GGm4nS3c/ufomount/README.md

# ufomount

Montura PTZ (pan-tilt) para cámara, controlada por Arduino UNO con shield
Ethernet y dos servos brushless GXservo GX3350ProBLS "X50 Pro":

- **Eje X (pan): 270°** — señal en D2
- **Eje Y (tilt): 180°** — señal en D3

Interfaz de escritorio en Python para el control fino (zoom) y el
seguimiento rápido (aviones), con posición en vivo, velocidades
configurables y log de actividad. Se conecta por USB o por red.

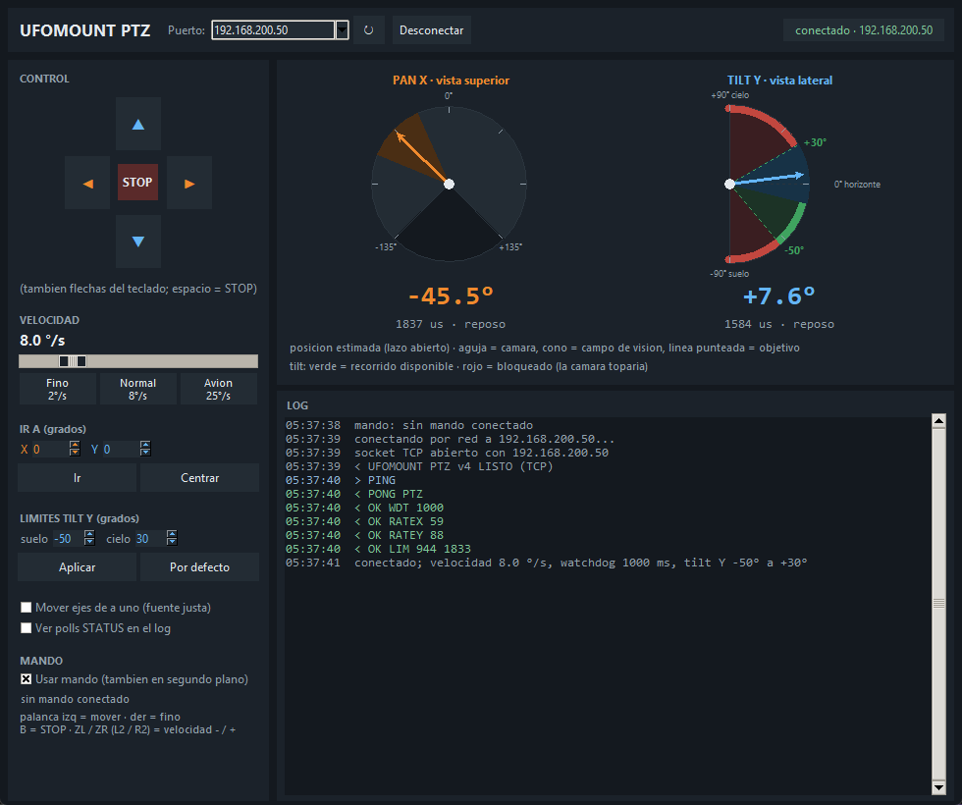
[picture p1: docs/img/gui-ptz.png]
GUI de control conectada a la montura por red: dial de pan, dial de tilt con el recorrido permitido en verde y el bloqueado en rojo, y log


## Estructura

| Ruta | Qué es |
|---|---|
| `firmware/ptztest/` | Firmware del UNO (v4): protocolo de líneas por USB y TCP, rampas de velocidad, auto-detach antizumbido, watchdog de enlace |
| `scripts/ptz_gui.py` | Interfaz gráfica (tkinter + pyserial): jog, presets de velocidad, diales de posición, logs |
| `scripts/*.ps1` | Utilidades por USB: verificación guiada, jog por consola, medición de consumo |
| `docs/GX3350-informe.md` | Informe técnico de los servos (specs, PWM, alimentación) |

## Uso rápido

```powershell
# Firmware (una vez): librerías y carga con arduino-cli
arduino-cli lib install Servo Ethernet
arduino-cli compile --fqbn arduino:avr:uno firmware/ptztest
arduino-cli upload -p COM5 --fqbn arduino:avr:uno firmware/ptztest

# Interfaz
pip install pyserial
pip install pygame                               # opcional: control por mando
python scripts/ptz_gui.py                        # último puerto que conectó (o la red)
python scripts/ptz_gui.py --port COM5            # USB
python scripts/ptz_gui.py --port 192.168.200.50  # red
```

En la GUI, el desplegable de puerto ofrece los COM detectados, la IP de
respaldo `192.168.200.50:5000` y las monturas que encuentre *Buscar*;
también se puede escribir otra `IP:puerto`. La GUI
recuerda el último puerto que conectó (en `~/.ufomount_ptz.json`, junto con
los límites del tilt).

## Control por mando

Con `pygame` instalado, la GUI lee un mando (probado con el Nintendo Switch
Pro Controller por USB; también sirven Xbox, PlayStation y genéricos) y
**sigue funcionando con la ventana en segundo plano**.

| Mando | Acción |
|---|---|
| Palanca izquierda | Mueve pan/tilt; cuanto más se inclina, más rápido (hasta la velocidad elegida en la GUI) |
| Palanca derecha | Igual, pero a un 25 % de esa velocidad (ajuste fino) |
| B | STOP |
| ZL / ZR (L2 / R2) | Preset de velocidad anterior / siguiente (Fino, Normal, Avión) |

Al soltar la palanca el eje se detiene. Respeta los límites del tilt; en
diagonal mueve los dos ejes a la vez, salvo que se marque "Mover ejes de a
uno" (entonces solo el más inclinado; útil con una fuente justa). La casilla *Usar
mando* lo desactiva; debajo se ven las palancas en vivo.

## Límites del tilt (eje Y)

Para que la cámara no tope, el eje Y solo recorre de **-50°** (suelo) a
**+30°** (cielo), con 0° = horizonte (1500 µs).

- El firmware arranca con ese rango (`LIMY 944 1833`), así queda protegido
  aunque no haya GUI conectada.
- En la GUI, *Límites tilt Y* permite cambiarlo; se guarda en
  `~/.ufomount_ptz.json` y se envía al firmware en cada conexión. *Por
  defecto* vuelve a -50°/+30°.
- El dial del tilt muestra en verde el recorrido disponible y en rojo el
  bloqueado.

## Control por red

| Parámetro | Valor (en `ptztest.ino`) |
|---|---|
| IP | Por **DHCP** al encender; si no hay servidor DHCP en 8 s, IP fija de respaldo 192.168.200.50 / 24 (gateway .254) |
| Puerto TCP | 5000 |
| Descubrimiento | UDP 5000: a `UFOMOUNT?` contesta `UFOMOUNT PTZ v4.1 ip=<ip>:5000 ...` |
| MAC | 02:55:46:4F:00:01 (administrada localmente) |

- **Encontrar la montura**: botón *Buscar* de la GUI (o
  `python scripts/ptz_gui.py --find`). Busca en la red local y, si en
  *Puerto* hay una IP de otra red (por ejemplo `192.168.210.0`), recorre
  también esa red /24: el broadcast no cruza routers.
- Para que tenga siempre la misma IP, reservarla en el router (DHCP) para
  la MAC de arriba. La red se toma al encender: al cambiarla de red,
  reiniciar la placa.
- Mismo protocolo que por USB (`PING`, `X <us>`, `STATUS`…), una línea por
  comando. `NET` informa el chip de la shield, el enlace, la IP (dhcp o
  fija) y el cliente.
- USB y red funcionan a la vez. Una conexión TCP a la vez: una nueva
  reemplaza a la anterior.
- Si la conexión TCP que movía la montura se cae, o su canal deja de
  hablar con el watchdog activo, la montura se detiene.
- Por red el UNO **no** se resetea al conectar (por USB sí): conserva su
  posición.
- Prueba manual: PuTTY en modo *Raw* a la IP de la montura, puerto 5000.
- Sin autenticación: pensado para una LAN de confianza.

## Conexionado

| Cable del servo | Va a |
|---|---|
| Franja blanca (señal) | D2 (X) / D3 (Y) |
| Central (V+) | Fuente externa 6,0–8,4 V (nunca el 5V del Arduino) |
| Restante (GND) | Negativo de fuente + GND del Arduino (tierra común) |

La shield Ethernet ocupa D10 (chip-select), D11–D13 (SPI) y D4 (SD): no
conectar servos ahí. Si la shield tiene soldado el puente de interrupción
(INT) a D2, ese pin también queda ocupado.

Si el RJ45 de la shield se apoya en el USB del UNO, la shield no calza a
fondo y los pines de ese extremo (D8–D10) pueden quedar sin contacto: usar
extensores de pines o cinta aislante sobre el USB.

Fuente recomendada para ambos ejes: ≥10 A a 6 V o ≥12 A a 7,4 V.
Detalles, protocolo serie completo y fuentes en
[docs/GX3350-informe.md](docs/GX3350-informe.md).

## Paquete portable

`python -m PyInstaller --onefile --windowed --name UfomountPTZ scripts/ptz_gui.py`
genera el ejecutable standalone (los binarios no se versionan; ver
Releases si hay alguno publicado). Con `pygame` instalado al compilar, el
`.exe` incluye el soporte de mando: en otro equipo con Windows 10/11 de 64
bits no hace falta instalar Python ni drivers. Al ser un ejecutable sin
firma, SmartScreen puede avisar la primera vez (*Más información →
Ejecutar de todas formas*).
