GGm4nS3c/ufomount/scripts/ptz_gui.py

#!/usr/bin/env python3
"""Interfaz de control de la montura PTZ ufomount.

Habla con el firmware ptztest v4 (Arduino UNO + shield Ethernet), por USB
(115200 baudios) o por red (TCP, mismo protocolo de lineas).
Eje X = pan 270 grados (D2) - Eje Y = tilt 180 grados (D3).

Uso:
    python scripts/ptz_gui.py                       # ultimo puerto que conecto (o red)
    python scripts/ptz_gui.py --port COM7           # por USB
    python scripts/ptz_gui.py --port 192.168.200.50 # por red (puerto 5000)
    python scripts/ptz_gui.py --check               # prueba de conexion sin GUI (COM5)
    python scripts/ptz_gui.py --find 192.168.210.0  # busca monturas (aqui y en esa red)

La posicion mostrada es la ESTIMADA (lazo abierto): el firmware sabe
donde comando al servo; el servo no tiene salida de telemetria real.
"""

import argparse
import json
import math
import os
import queue
import re
import socket
import sys
import threading
import time
import tkinter as tk
from pathlib import Path
from tkinter import ttk

try:
    import serial
    import serial.urlhandler.protocol_socket  # noqa: F401  (socket://, PyInstaller)
    from serial.tools import list_ports
except ImportError:
    print("Falta pyserial:  python -m pip install pyserial")
    sys.exit(1)

try:   # mando opcional: python -m pip install pygame
    os.environ.setdefault("SDL_JOYSTICK_ALLOW_BACKGROUND_EVENTS", "1")  # sin foco
    os.environ.setdefault("SDL_WINDOWS_ENABLE_MESSAGELOOP", "0")  # no tocar a Tk
    os.environ.setdefault("PYGAME_HIDE_SUPPORT_PROMPT", "1")
    import pygame
    from pygame._sdl2 import controller as sdl_controller
except ImportError:
    pygame = None

# ----------------------------- configuracion -----------------------------
PORT_DEFAULT = "COM5"
BAUD = 115200
BOOT_WAIT_S = 2.5          # el UNO se resetea al abrir el puerto
NET_DEFAULT = "192.168.200.50:5000"   # IP de respaldo del firmware (sin DHCP)
NET_TCP_PORT = 5000
NET_WAIT_S = 0.3           # por red no hay reset: solo esperar el saludo
DISCOVERY_PORT = 5000      # UDP: "UFOMOUNT?" -> la montura contesta su IP
DISCOVERY_MSG = b"UFOMOUNT?"
DISCOVERY_WAIT_S = 1.5
IP_RE = re.compile(r"\b\d{1,3}(?:\.\d{1,3}){3}\b")

X_MIN, X_MAX = 500, 2500   # pulso (us)
Y_MIN, Y_MAX = 500, 2500
X_DEG_TOTAL = 270.0        # recorrido fisico del eje X
Y_DEG_TOTAL = 180.0
INVERT_X = True            # el servo X gira al reves (subir el pulso = izquierda)
INVERT_Y = False
Y_LIM_DEFAULT = (-50.0, 30.0)   # tilt permitido (suelo, cielo): mas alla topa
CONFIG_PATH = Path.home() / ".ufomount_ptz.json"   # limites elegidos en la GUI

X_US_PER_DEG = (X_MAX - X_MIN) / X_DEG_TOTAL   # ~7.41
Y_US_PER_DEG = (Y_MAX - Y_MIN) / Y_DEG_TOTAL   # ~11.11

SPEED_PRESETS = [("Fino", 2.0), ("Normal", 8.0), ("Avion", 25.0)]  # grados/s
SPEED_MIN, SPEED_MAX = 0.5, 40.0

PAD_POLL_MS = 50
PAD_DEADZONE = 0.15        # las palancas del Switch Pro derivan un poco
PAD_FINE = 0.25            # palanca derecha: fraccion de la velocidad elegida
PAD_TRIGGER_ON, PAD_TRIGGER_OFF = 0.6, 0.3   # ZL/ZR (L2/R2) como botones

STATUS_POLL_S = 0.2
CMD_SETTLE_S = 0.7         # ventana en que un comando aun no se refleja en STATUS
WDT_MS = 1000              # watchdog de enlace en el firmware

STATUS_RE = re.compile(
    r"attX=(\d) attY=(\d) X=(\d+)/(\d+) \[(\d+)-(\d+)\]"
    r" Y=(\d+)/(\d+) \[(\d+)-(\d+)\] rateX=(\d+) rateY=(\d+) idle=(\d+)"
)
NET_RE = re.compile(r"^\d{1,3}(?:\.\d{1,3}){3}(?::\d+)?$")

# ------------------------------- colores ---------------------------------
C_BG = "#14191F"
C_PANEL = "#1B222A"
C_PANEL2 = "#232C34"
C_TEXT = "#E4E9ED"
C_MUTED = "#92A0AC"
C_X = "#F08A2E"        # pan  (naranja)
C_Y = "#64B5F6"        # tilt (azul)
C_OK = "#7FC698"
C_ERR = "#E57373"
C_WARN = "#D9A93F"
C_LINE = "#2A343D"
C_LIM_OK = "#3FA35F"   # tilt permitido (borde del dial)
C_LIM_BAD = "#C2473F"  # tilt bloqueado
C_ZONE_OK = "#1C3326"  # relleno de las mismas zonas
C_ZONE_BAD = "#3A1E21"


def us_to_deg(us, axis):
    if axis == "X":
        deg = (us - (X_MIN + X_MAX) / 2) / X_US_PER_DEG
        return -deg if INVERT_X else deg
    deg = (us - (Y_MIN + Y_MAX) / 2) / Y_US_PER_DEG
    return -deg if INVERT_Y else deg


def deg_to_us(deg, axis):
    if axis == "X":
        if INVERT_X:
            deg = -deg
        return int(round((X_MIN + X_MAX) / 2 + deg * X_US_PER_DEG))
    if INVERT_Y:
        deg = -deg
    return int(round((Y_MIN + Y_MAX) / 2 + deg * Y_US_PER_DEG))


def valid_y_lim(lo, hi):
    return -Y_DEG_TOTAL / 2 <= lo < hi <= Y_DEG_TOTAL / 2 and hi - lo >= 5


def load_cfg():
    """Ajustes guardados por la GUI (limites, ultimo puerto)."""
    try:
        cfg = json.loads(CONFIG_PATH.read_text(encoding="utf-8"))
    except (OSError, ValueError):
        return {}
    return cfg if isinstance(cfg, dict) else {}


def save_cfg(**values):
    cfg = load_cfg()
    cfg.update(values)
    CONFIG_PATH.write_text(json.dumps(cfg, indent=2), encoding="utf-8")


def load_y_lim():
    """Limites de tilt guardados por la GUI; si no hay o no sirven, el defecto."""
    try:
        lo, hi = load_cfg()["y_lim"]
        lo, hi = float(lo), float(hi)
    except (ValueError, KeyError, TypeError):
        return Y_LIM_DEFAULT
    return (lo, hi) if valid_y_lim(lo, hi) else Y_LIM_DEFAULT


def save_y_lim(lo, hi):
    save_cfg(y_lim=[lo, hi])


def ip_hints(text):
    """IPs validas dentro de un texto ("192.168.210.0", "10.0.0.7:5000")."""
    return [ip for ip in IP_RE.findall(text or "")
            if all(int(o) <= 255 for o in ip.split(".")) and ip != "0.0.0.0"]


def local_ipv4():
    try:
        ips = socket.gethostbyname_ex(socket.gethostname())[2]
    except OSError:
        return []
    return [ip for ip in ips if not ip.startswith(("127.", "169.254."))]


def discover(hints=(), wait=DISCOVERY_WAIT_S):
    """Busca monturas: devuelve {ip: respuesta del firmware}.

    Pregunta por broadcast en cada red local y, para la red /24 de cada IP
    de `hints`, a cada direccion una por una: el broadcast no cruza routers.
    """
    targets = {"255.255.255.255"}
    targets.update(ip.rsplit(".", 1)[0] + ".255" for ip in local_ipv4())
    for net in {ip.rsplit(".", 1)[0] for ip in hints}:
        targets.update(f"{net}.{i}" for i in range(1, 255))
    found = {}
    with socket.socket(socket.AF_INET, socket.SOCK_DGRAM) as s:
        s.setsockopt(socket.SOL_SOCKET, socket.SO_BROADCAST, 1)
        s.bind(("", 0))
        for t in targets:
            try:
                s.sendto(DISCOVERY_MSG, (t, DISCOVERY_PORT))
            except OSError:
                pass   # red inalcanzable desde este equipo
        s.settimeout(0.2)
        end = time.time() + wait
        while time.time() < end:
            try:
                data, (ip, _) = s.recvfrom(256)
            except (socket.timeout, ConnectionResetError):
                continue   # Windows: un "puerto cerrado" por ICMP no corta la busqueda
            text = data.decode("ascii", errors="replace").strip()
            if text.startswith("UFOMOUNT"):
                found[ip] = text
    return found


def is_net_port(port):
    return port.startswith("socket://") or bool(NET_RE.match(port))


def open_port(port, timeout):
    """COMx -> USB; IP[:puerto] o socket://host:puerto -> red (TCP).

    Ambos devuelven un objeto pyserial con la misma interfaz
    (readline/write/close), asi el resto del codigo no distingue.
    """
    if NET_RE.match(port):
        port = "socket://" + (port if ":" in port else f"{port}:{NET_TCP_PORT}")
    if port.startswith("socket://"):
        return serial.serial_for_url(port, timeout=timeout)
    return serial.Serial(port, BAUD, timeout=timeout)


class SerialLink:
    """Conexion (USB o TCP) con hilo lector generacional.

    Cada open() crea un hilo con SU PROPIO handle y SU PROPIO Event de
    parada: un hilo viejo nunca puede observar (ni matar) una conexion
    nueva, aunque el usuario conecte/desconecte rapidamente.
    """

    def __init__(self, rxq):
        self.rxq = rxq
        self.ser = None
        self._stop = None
        self.is_net = False

    @property
    def connected(self):
        return self.ser is not None and self.ser.is_open

    def open(self, port):
        ser = open_port(port, timeout=0.2)
        stop = threading.Event()
        self.is_net = is_net_port(port)
        self.ser = ser
        self._stop = stop
        threading.Thread(target=self._reader, args=(ser, stop),
                         daemon=True).start()

    def close(self):
        if self._stop is not None:
            self._stop.set()
        if self.ser is not None:
            try:
                self.ser.close()
            except Exception:
                pass
            self.ser = None

    def write_line(self, text):
        self.ser.write((text + "\n").encode("ascii"))

    def _reader(self, ser, stop):
        while not stop.is_set():
            try:
                raw = ser.readline()
            except Exception:
                if not stop.is_set():
                    self.rxq.put(("lost", ""))
                return
            if raw:
                line = raw.decode("ascii", errors="replace").strip()
                if line:
                    self.rxq.put(("rx", line))


class Gamepad:
    """Mando (Switch Pro, Xbox, PlayStation...) leido con SDL via pygame.

    Se lee aunque la ventana no tenga el foco. poll() devuelve None si no
    hay mando; si hay, las palancas en -1..1 (Y positivo = arriba) y los
    botones apretados desde la lectura anterior ("ZL"/"ZR" para los
    gatillos, que SDL entrega como ejes).
    """

    BATTERY = {"empty": "vacia", "low": "baja", "medium": "media",
               "full": "llena", "max": "llena", "wired": "con cable"}

    def __init__(self):
        self.available = pygame is not None
        self.pad = None
        self.js = None       # mismo mando visto como joystick (bateria)
        self.trig = {"ZL": False, "ZR": False}
        if self.available:
            pygame.display.init()   # el bucle de eventos de SDL lo necesita
            sdl_controller.init()

    @property
    def name(self):
        return self.pad.name if self.pad is not None else ""

    def _open(self):
        for i in range(sdl_controller.get_count()):
            if sdl_controller.is_controller(i):
                try:
                    return sdl_controller.Controller(i)
                except pygame.error:
                    pass
        return None

    def battery(self):
        """Nivel de bateria segun SDL (solo 4 escalones) o None."""
        if self.js is None:
            return None
        try:
            return self.BATTERY.get(self.js.get_power_level())
        except (AttributeError, pygame.error):
            return None

    def _triggers(self, zl, zr):
        """Gatillos recien apretados; la histeresis evita repetir el pulso."""
        pressed = set()
        for name, v in (("ZL", zl), ("ZR", zr)):
            if not self.trig[name] and v >= PAD_TRIGGER_ON:
                self.trig[name] = True
                pressed.add(name)
            elif self.trig[name] and v <= PAD_TRIGGER_OFF:
                self.trig[name] = False
        return pressed

    def poll(self):
        if not self.available:
            return None
        pressed = set()
        for ev in pygame.event.get():
            if ev.type == pygame.CONTROLLERBUTTONDOWN:
                pressed.add(ev.button)
        if self.pad is not None and not self.pad.attached():
            self.pad = self.js = None
        if self.pad is None:
            self.pad = self._open()
            if self.pad is None:
                return None
            try:
                self.js = self.pad.as_joystick()
            except (AttributeError, pygame.error):
                self.js = None
            pressed.clear()

        def axis(a):
            return self.pad.get_axis(a) / 32767

        pressed |= self._triggers(axis(pygame.CONTROLLER_AXIS_TRIGGERLEFT),
                                  axis(pygame.CONTROLLER_AXIS_TRIGGERRIGHT))
        return {"lx": axis(pygame.CONTROLLER_AXIS_LEFTX),
                "ly": -axis(pygame.CONTROLLER_AXIS_LEFTY),
                "rx": axis(pygame.CONTROLLER_AXIS_RIGHTX),
                "ry": -axis(pygame.CONTROLLER_AXIS_RIGHTY),
                "pressed": pressed}


class PtzGui:
    def __init__(self, root, port=PORT_DEFAULT):
        self.root = root
        self.rxq = queue.Queue()
        self.link = SerialLink(self.rxq)

        self.cur = {"X": 1500, "Y": 1500}
        self.tgt = {"X": 1500, "Y": 1500}
        self.att = {"X": False, "Y": False}
        self.jogging = {"X": 0, "Y": 0}          # -1, 0, +1
        self.jog_src = {"X": set(), "Y": set()}  # duenos del jog: mouse/key
        self.move_sent = {"X": 0.0, "Y": 0.0}    # ts del ultimo comando de mov.
        self.keys_down = set()
        self.last_tx = 0.0
        self.awaiting_reply = False
        self.pong_ok = False
        self._pong_late = False
        self._speed_job = None
        self._handshake_job = None
        self._pending_y = None                   # (y_us, ts) goto secuencial
        self.y_lim = load_y_lim()                # tilt permitido (grados)
        self.lim_sent = 0.0                      # ts del ultimo LIMY enviado
        self.pad = Gamepad()
        self.pad_rate = {"X": None, "Y": None}   # RATE puesto por el mando
        self.pad_rate_ts = {"X": 0.0, "Y": 0.0}
        self._pad_text = None
        self._pad_batt = None
        self._pad_batt_tick = 0
        self._batt_shown = "-"                   # "-" = icono oculto

        self._build_ui(port)
        self._tick()
        self._pad_tick()

    # --------------------------- construccion UI ---------------------------
    def _build_ui(self, port):
        r = self.root
        r.title("UFOMOUNT PTZ")
        r.configure(bg=C_BG)
        r.geometry("980x820")
        r.minsize(760, 720)

        style = ttk.Style(r)
        style.theme_use("clam")
        style.configure("TFrame", background=C_BG)
        style.configure("Panel.TFrame", background=C_PANEL)
        style.configure("TLabel", background=C_BG, foreground=C_TEXT)
        style.configure("Panel.TLabel", background=C_PANEL, foreground=C_TEXT)
        style.configure("Muted.TLabel", background=C_PANEL, foreground=C_MUTED)
        style.configure("TButton", background=C_PANEL2, foreground=C_TEXT,
                        borderwidth=0, focuscolor=C_PANEL2, padding=6)
        style.map("TButton", background=[("active", C_LINE)])
        style.configure("TCheckbutton", background=C_PANEL, foreground=C_MUTED)
        style.map("TCheckbutton", background=[("active", C_PANEL)])
        style.configure("TCombobox", fieldbackground=C_PANEL2,
                        background=C_PANEL2, foreground=C_TEXT)
        style.configure("Horizontal.TScale", background=C_PANEL)

        r.columnconfigure(0, weight=0)
        r.columnconfigure(1, weight=1)
        r.rowconfigure(1, weight=1)

        # ---- barra superior: conexion ----
        top = ttk.Frame(r, style="Panel.TFrame", padding=8)
        top.grid(row=0, column=0, columnspan=2, sticky="ew", padx=8, pady=(8, 4))
        top.columnconfigure(6, weight=1)

        ttk.Label(top, text="UFOMOUNT PTZ", style="Panel.TLabel",
                  font=("Segoe UI", 13, "bold")).grid(row=0, column=0, padx=(2, 14))
        ttk.Label(top, text="Puerto:", style="Muted.TLabel").grid(row=0, column=1)
        self.port_var = tk.StringVar(value=port)
        self.port_cb = ttk.Combobox(top, textvariable=self.port_var, width=20,
                                    values=self._ports())
        self.port_cb.grid(row=0, column=2, padx=4)
        ttk.Button(top, text="↻", width=3,
                   command=lambda: self.port_cb.configure(values=self._ports())
                   ).grid(row=0, column=3)
        self.find_btn = ttk.Button(top, text="Buscar", command=self.find_mounts)
        self.find_btn.grid(row=0, column=4, padx=(4, 0))
        self.conn_btn = ttk.Button(top, text="Conectar", command=self.toggle_conn)
        self.conn_btn.grid(row=0, column=5, padx=8)
        # bateria del mando: solo aparece con un mando conectado
        self.batt_box = tk.Frame(top, bg=C_PANEL)
        tk.Label(self.batt_box, text="mando", bg=C_PANEL, fg=C_MUTED,
                 font=("Segoe UI", 8)).pack(side="left", padx=(0, 4))
        self.batt_cv = tk.Canvas(self.batt_box, width=38, height=18,
                                 bg=C_PANEL, highlightthickness=0)
        self.batt_cv.pack(side="left")
        self.batt_box.grid(row=0, column=6, sticky="e", padx=10)
        self.batt_box.grid_remove()
        self.conn_lbl = tk.Label(top, text="desconectado", bg=C_PANEL2,
                                 fg=C_MUTED, padx=10, pady=2)
        self.conn_lbl.grid(row=0, column=7, sticky="e", padx=2)

        # ---- columna izquierda: controles ----
        left = ttk.Frame(r, style="Panel.TFrame", padding=10)
        left.grid(row=1, column=0, sticky="nsw", padx=(8, 4), pady=4)

        ttk.Label(left, text="CONTROL", style="Muted.TLabel",
                  font=("Segoe UI", 8, "bold")).pack(anchor="w")

        pad = tk.Frame(left, bg=C_PANEL)
        pad.pack(pady=8)
        mk = dict(width=4, height=2, bd=0, font=("Segoe UI", 12, "bold"),
                  activebackground=C_LINE, takefocus=0)
        self.btn_up = tk.Button(pad, text="▲", bg=C_PANEL2, fg=C_Y, **mk)
        self.btn_dn = tk.Button(pad, text="▼", bg=C_PANEL2, fg=C_Y, **mk)
        self.btn_lf = tk.Button(pad, text="◀", bg=C_PANEL2, fg=C_X, **mk)
        self.btn_rt = tk.Button(pad, text="▶", bg=C_PANEL2, fg=C_X, **mk)
        stop = tk.Button(pad, text="STOP", bg="#5A2A2A", fg=C_TEXT, bd=0,
                         font=("Segoe UI", 9, "bold"), width=5, height=2,
                         activebackground="#7A3A3A", command=self.stop_all)
        self.btn_up.grid(row=0, column=1, padx=3, pady=3)
        self.btn_lf.grid(row=1, column=0, padx=3, pady=3)
        stop.grid(row=1, column=1, padx=3, pady=3)
        self.btn_rt.grid(row=1, column=2, padx=3, pady=3)
        self.btn_dn.grid(row=2, column=1, padx=3, pady=3)

        for btn, axis, d in ((self.btn_lf, "X", -1), (self.btn_rt, "X", +1),
                             (self.btn_up, "Y", +1), (self.btn_dn, "Y", -1)):
            btn.bind("<ButtonPress-1>",
                     lambda e, a=axis, s=d: self.jog_start(a, s, "mouse"))
            btn.bind("<ButtonRelease-1>",
                     lambda e, a=axis: self.jog_stop(a, "mouse"))

        ttk.Label(left, text="(tambien flechas del teclado; espacio = STOP)",
                  style="Muted.TLabel").pack()

        # velocidad
        ttk.Label(left, text="VELOCIDAD", style="Muted.TLabel",
                  font=("Segoe UI", 8, "bold")).pack(anchor="w", pady=(14, 0))
        self.speed_var = tk.DoubleVar(value=8.0)
        self.speed_lbl = ttk.Label(left, text="8.0 °/s", style="Panel.TLabel",
                                   font=("Segoe UI", 11, "bold"))
        self.speed_lbl.pack(anchor="w")
        sc = ttk.Scale(left, from_=SPEED_MIN, to=SPEED_MAX, orient="horizontal",
                       variable=self.speed_var, command=self._speed_changed,
                       length=190)
        sc.pack(fill="x", pady=2)
        prow = tk.Frame(left, bg=C_PANEL)
        prow.pack(fill="x", pady=2)
        for name, val in SPEED_PRESETS:
            b = tk.Button(prow, text=f"{name}\n{val:g}°/s", bd=0,
                          bg=C_PANEL2, fg=C_TEXT, font=("Segoe UI", 8),
                          activebackground=C_LINE, width=7, takefocus=0,
                          command=lambda v=val: self.set_speed(v))
            b.pack(side="left", padx=2, expand=True, fill="x")

        # ir a posicion
        ttk.Label(left, text="IR A (grados)", style="Muted.TLabel",
                  font=("Segoe UI", 8, "bold")).pack(anchor="w", pady=(14, 2))
        grow = tk.Frame(left, bg=C_PANEL)
        grow.pack(fill="x")
        self.goto_x = tk.Spinbox(grow, from_=-X_DEG_TOTAL / 2, to=X_DEG_TOTAL / 2,
                                 increment=1, width=6, bg=C_PANEL2, fg=C_X,
                                 buttonbackground=C_PANEL2, bd=0,
                                 insertbackground=C_TEXT)
        self.goto_y = tk.Spinbox(grow, from_=-Y_DEG_TOTAL / 2, to=Y_DEG_TOTAL / 2,
                                 increment=1, width=6, bg=C_PANEL2, fg=C_Y,
                                 buttonbackground=C_PANEL2, bd=0,
                                 insertbackground=C_TEXT)
        self.goto_x.delete(0, "end"); self.goto_x.insert(0, "0")
        self.goto_y.delete(0, "end"); self.goto_y.insert(0, "0")
        tk.Label(grow, text="X", bg=C_PANEL, fg=C_X).pack(side="left")
        self.goto_x.pack(side="left", padx=(2, 8))
        tk.Label(grow, text="Y", bg=C_PANEL, fg=C_Y).pack(side="left")
        self.goto_y.pack(side="left", padx=2)
        grow2 = tk.Frame(left, bg=C_PANEL)
        grow2.pack(fill="x", pady=4)
        ttk.Button(grow2, text="Ir", command=self.goto).pack(
            side="left", expand=True, fill="x", padx=(0, 2))
        ttk.Button(grow2, text="Centrar", command=self.center).pack(
            side="left", expand=True, fill="x", padx=(2, 0))

        # limites del tilt: que la camara no tope
        ttk.Label(left, text="LIMITES TILT Y (grados)", style="Muted.TLabel",
                  font=("Segoe UI", 8, "bold")).pack(anchor="w", pady=(14, 2))
        lrow = tk.Frame(left, bg=C_PANEL)
        lrow.pack(fill="x")
        spin = dict(from_=-Y_DEG_TOTAL / 2, to=Y_DEG_TOTAL / 2, increment=1,
                    width=5, bg=C_PANEL2, fg=C_Y, buttonbackground=C_PANEL2,
                    bd=0, insertbackground=C_TEXT)
        self.lim_lo = tk.Spinbox(lrow, **spin)
        self.lim_hi = tk.Spinbox(lrow, **spin)
        tk.Label(lrow, text="suelo", bg=C_PANEL, fg=C_MUTED).pack(side="left")
        self.lim_lo.pack(side="left", padx=(2, 8))
        tk.Label(lrow, text="cielo", bg=C_PANEL, fg=C_MUTED).pack(side="left")
        self.lim_hi.pack(side="left", padx=2)
        self._show_y_lim()
        lrow2 = tk.Frame(left, bg=C_PANEL)
        lrow2.pack(fill="x", pady=4)
        ttk.Button(lrow2, text="Aplicar", command=self.apply_y_lim).pack(
            side="left", expand=True, fill="x", padx=(0, 2))
        ttk.Button(lrow2, text="Por defecto",
                   command=lambda: self.apply_y_lim(*Y_LIM_DEFAULT)).pack(
            side="left", expand=True, fill="x", padx=(2, 0))

        # opciones
        self.seq_var = tk.BooleanVar(value=False)
        ttk.Checkbutton(left, text="Mover ejes de a uno (fuente justa)",
                        variable=self.seq_var).pack(anchor="w", pady=(12, 0))
        self.dbg_var = tk.BooleanVar(value=False)
        ttk.Checkbutton(left, text="Ver polls STATUS en el log",
                        variable=self.dbg_var).pack(anchor="w")

        # mando: funciona tambien con la ventana en segundo plano
        ttk.Label(left, text="MANDO", style="Muted.TLabel",
                  font=("Segoe UI", 8, "bold")).pack(anchor="w", pady=(14, 0))
        self.pad_var = tk.BooleanVar(value=self.pad.available)
        ttk.Checkbutton(left, text="Usar mando (tambien en segundo plano)",
                        variable=self.pad_var).pack(anchor="w")
        self.pad_lbl = tk.Label(left, text="", bg=C_PANEL, fg=C_MUTED,
                                font=("Segoe UI", 8), justify="left")
        self.pad_lbl.pack(anchor="w")
        ttk.Label(left, text="palanca izq = mover · der = fino\n"
                  "B = STOP · ZL / ZR (L2 / R2) = velocidad - / +",
                  style="Muted.TLabel", font=("Segoe UI", 8)).pack(anchor="w")

        # ---- columna derecha: posicion + log ----
        right = ttk.Frame(r, style="TFrame")
        right.grid(row=1, column=1, sticky="nsew", padx=(4, 8), pady=4)
        right.columnconfigure(0, weight=1)
        right.rowconfigure(1, weight=1)

        pos = ttk.Frame(right, style="Panel.TFrame", padding=10)
        pos.grid(row=0, column=0, sticky="ew")
        pos.columnconfigure(0, weight=1)
        pos.columnconfigure(1, weight=1)

        tk.Label(pos, text="PAN X · vista superior", bg=C_PANEL, fg=C_X,
                 font=("Segoe UI", 9, "bold")).grid(row=0, column=0)
        tk.Label(pos, text="TILT Y · vista lateral", bg=C_PANEL, fg=C_Y,
                 font=("Segoe UI", 9, "bold")).grid(row=0, column=1)
        self.dial_x = tk.Canvas(pos, height=190, bg=C_PANEL,
                                highlightthickness=0)
        self.dial_y = tk.Canvas(pos, height=190, bg=C_PANEL,
                                highlightthickness=0)
        self.dial_x.grid(row=1, column=0, sticky="ew", padx=(0, 6))
        self.dial_y.grid(row=1, column=1, sticky="ew", padx=(6, 0))

        self.deg_x = tk.Label(pos, text="+0.0°", bg=C_PANEL, fg=C_X,
                              font=("Consolas", 20, "bold"))
        self.deg_y = tk.Label(pos, text="+0.0°", bg=C_PANEL, fg=C_Y,
                              font=("Consolas", 20, "bold"))
        self.us_x = tk.Label(pos, text="1500 us · reposo", bg=C_PANEL,
                             fg=C_MUTED, font=("Consolas", 9))
        self.us_y = tk.Label(pos, text="1500 us · reposo", bg=C_PANEL,
                             fg=C_MUTED, font=("Consolas", 9))
        self.deg_x.grid(row=2, column=0)
        self.deg_y.grid(row=2, column=1)
        self.us_x.grid(row=3, column=0)
        self.us_y.grid(row=3, column=1)

        for c in (self.dial_x, self.dial_y):
            c.bind("<Configure>", lambda e: self._redraw_dials())
        tk.Label(pos, text="posicion estimada (lazo abierto) · aguja = camara, "
                 "cono = campo de vision, linea punteada = objetivo",
                 bg=C_PANEL, fg=C_MUTED, font=("Segoe UI", 8)).grid(
                     row=4, column=0, columnspan=2, sticky="w", pady=(4, 0))
        tk.Label(pos, text="tilt: verde = recorrido disponible · rojo = bloqueado "
                 "(la camara toparia)",
                 bg=C_PANEL, fg=C_MUTED, font=("Segoe UI", 8)).grid(
                     row=5, column=0, columnspan=2, sticky="w")

        logf = ttk.Frame(right, style="Panel.TFrame", padding=(8, 6))
        logf.grid(row=1, column=0, sticky="nsew", pady=(6, 0))
        logf.columnconfigure(0, weight=1)
        logf.rowconfigure(1, weight=1)
        ttk.Label(logf, text="LOG", style="Muted.TLabel",
                  font=("Segoe UI", 8, "bold")).grid(row=0, column=0, sticky="w")
        self.log = tk.Text(logf, bg=C_BG, fg=C_TEXT, bd=0, wrap="none",
                           font=("Consolas", 9), state="disabled")
        sb = ttk.Scrollbar(logf, command=self.log.yview)
        self.log.configure(yscrollcommand=sb.set)
        self.log.grid(row=1, column=0, sticky="nsew", pady=(4, 0))
        sb.grid(row=1, column=1, sticky="ns")
        for tag, color in (("tx", "#8FB4D8"), ("rx", C_OK), ("err", C_ERR),
                           ("warn", C_WARN), ("info", C_MUTED), ("dim", "#5A6874")):
            self.log.tag_configure(tag, foreground=color)

        # teclado y foco
        r.bind("<KeyPress>", self._key_press)
        r.bind("<KeyRelease>", self._key_release)
        r.bind("<FocusOut>",
               lambda e: self.root.after_idle(self._app_focus_check))
        r.protocol("WM_DELETE_WINDOW", self._on_close)

    def _ports(self):
        usb = [p.device for p in list_ports.comports()] or [PORT_DEFAULT]
        return usb + [NET_DEFAULT]

    # ------------------------- buscar monturas ------------------------------
    def find_mounts(self):
        # la IP escrita en Puerto (o la ultima que conecto) senala que otra
        # red recorrer, p. ej. "192.168.210.0" para la red 192.168.210.x
        hints = set(ip_hints(self.port_var.get()))
        hints.update(ip_hints(load_cfg().get("port", "")))
        nets = sorted({ip.rsplit(".", 1)[0] + ".x" for ip in hints})
        self.log_line("buscando monturas en la red local"
                      + (f" y en {', '.join(nets)}" if nets else "") + "...",
                      "info")
        self.find_btn.configure(state="disabled")
        threading.Thread(target=lambda: self.rxq.put(("found", discover(hints))),
                         daemon=True).start()

    def _show_found(self, found):
        self.find_btn.configure(state="normal")
        if not found:
            self.log_line("no se encontro ninguna montura. Si esta en otra red, "
                          "escribe en Puerto una IP de esa red (p. ej. "
                          "192.168.210.0) y vuelve a Buscar", "warn")
            return
        ports = [f"{ip}:{NET_TCP_PORT}" for ip in sorted(found)]
        for ip in sorted(found):
            self.log_line(f"encontrada en {ip}: {found[ip]}", "rx")
        self.port_cb.configure(values=ports + self._ports())
        if not self.link.connected:
            self.port_var.set(ports[0])
            self.log_line(f"puerto -> {ports[0]}: pulsa Conectar", "info")

    # ------------------------------- log -----------------------------------
    def log_line(self, text, tag="info"):
        ts = time.strftime("%H:%M:%S")
        self.log.configure(state="normal")
        self.log.insert("end", f"{ts}  {text}\n", tag)
        if int(self.log.index("end-1c").split(".")[0]) > 500:
            self.log.delete("1.0", "2.0")
        self.log.see("end")
        self.log.configure(state="disabled")

    # ----------------------------- conexion ---------------------------------
    def toggle_conn(self):
        if self.link.connected:
            # detener antes de soltar el enlace: no abandonar la montura en
            # movimiento (el watchdog del firmware es la segunda red).
            try:
                self.link.write_line("STOP")
                self.log_line("> STOP (antes de desconectar)", "tx")
            except Exception:
                pass
            self.disconnect("desconectado por el usuario")
            return
        port = self.port_var.get().strip()
        if is_net_port(port):
            # create_connection bloquea hasta 5 s si la IP no contesta
            self.log_line(f"conectando por red a {port}...", "info")
            self.root.update_idletasks()
        try:
            self.link.open(port)
        except Exception as exc:
            self.log_line(f"ERROR abriendo {port}: {exc}", "err")
            return
        self._reset_local_state()
        self.conn_lbl.configure(text=f"conectando a {port}...", fg=C_WARN)
        self.conn_btn.configure(text="Desconectar")
        if self.link.is_net:
            wait = NET_WAIT_S
            self.log_line(f"socket TCP abierto con {port}", "info")
        else:
            wait = BOOT_WAIT_S
            self.log_line(f"puerto {port} abierto, esperando arranque del UNO "
                          f"({BOOT_WAIT_S:.0f} s)...", "info")
        self._handshake_job = self.root.after(int(wait * 1000), self._handshake)

    def _reset_local_state(self):
        self.cur = {"X": 1500, "Y": 1500}
        self.tgt = {"X": 1500, "Y": 1500}
        self.att = {"X": False, "Y": False}
        self.jogging = {"X": 0, "Y": 0}
        self.jog_src = {"X": set(), "Y": set()}
        self.move_sent = {"X": 0.0, "Y": 0.0}
        self._pending_y = None
        self.pong_ok = False
        self._pong_late = False
        self.awaiting_reply = False

    def _handshake(self):
        self._handshake_job = None
        if not self.link.connected:
            return
        self.pong_ok = False
        self.send("PING")
        self.send(f"WDT {WDT_MS}", log=False)
        self.send(f"RATEX {max(5, int(self.speed_var.get() * X_US_PER_DEG))}",
                  log=False)
        self.send(f"RATEY {max(5, int(self.speed_var.get() * Y_US_PER_DEG))}",
                  log=False)
        self._send_y_lim()
        self.root.after(1500, self._check_pong)
        if not self.link.is_net:
            self.log_line("Nota: el UNO se resetea al conectar y su posicion "
                          "estimada vuelve a 0°/0°. Si la montura NO esta "
                          "centrada fisicamente, el primer movimiento puede "
                          "dar un salto.", "warn")

    def _check_pong(self):
        if not self.link.connected:
            return
        if self.pong_ok:
            self.conn_lbl.configure(text=f"conectado · {self.port_var.get()}",
                                    fg=C_OK)
            try:   # la proxima vez la GUI abre con este puerto
                save_cfg(port=self.port_var.get().strip())
            except OSError:
                pass
            self.log_line(f"conectado; velocidad {self.speed_var.get():.1f} °/s"
                          f", watchdog {WDT_MS} ms, tilt Y "
                          f"{self.y_lim[0]:+g}° a {self.y_lim[1]:+g}°", "info")
        else:
            self._pong_late = True
            self.conn_lbl.configure(text="sin respuesta del firmware",
                                    fg=C_WARN)
            self.log_line("no llego PONG: ¿es el puerto correcto? "
                          "(¿firmware ptztest cargado?)", "err")

    def disconnect(self, reason):
        if self._handshake_job:
            self.root.after_cancel(self._handshake_job)
            self._handshake_job = None
        self._pending_y = None
        self.link.close()
        self.conn_btn.configure(text="Conectar")
        self.conn_lbl.configure(text="desconectado", fg=C_MUTED)
        self.att = {"X": False, "Y": False}
        self.jogging = {"X": 0, "Y": 0}
        self.jog_src = {"X": set(), "Y": set()}
        self.log_line(reason, "warn")

    def send(self, cmd, log=True):
        if not self.link.connected:
            if log:
                self.log_line(f"no conectado, se ignora: {cmd}", "warn")
            return False
        try:
            self.link.write_line(cmd)
        except Exception as exc:
            self.disconnect(f"ERROR de escritura ({exc}); desconectado")
            return False
        self.last_tx = time.time()
        if cmd != "STATUS":
            self.awaiting_reply = True
            self.root.after(900, self._check_reply)
        if log:
            self.log_line(f"> {cmd}", "tx")
        return True

    def _check_reply(self):
        # Solo los acks OK/ERR/PONG limpian la bandera: las respuestas a los
        # polls STATUS no cuentan (si no, un comando perdido pasaria callado).
        if self.awaiting_reply:
            self.awaiting_reply = False
            self.log_line("sin respuesta del firmware a un comando", "err")

    # ---------------------------- limites ----------------------------------
    def _lim_us(self, axis):
        """Pulso permitido: X completo, Y segun los limites de tilt."""
        if axis == "X":
            return X_MIN, X_MAX
        a, b = (deg_to_us(d, "Y") for d in self.y_lim)
        return min(a, b), max(a, b)

    def _show_y_lim(self):
        for box, val in ((self.lim_lo, self.y_lim[0]), (self.lim_hi, self.y_lim[1])):
            box.delete(0, "end")
            box.insert(0, f"{val:g}")

    def _send_y_lim(self):
        # el firmware re-acota el objetivo: si Y quedo fuera, va al limite
        lo, hi = self._lim_us("Y")
        if self.send(f"LIMY {lo} {hi}", log=False):
            self.lim_sent = time.time()

    def apply_y_lim(self, lo=None, hi=None):
        try:
            lo = float(self.lim_lo.get()) if lo is None else lo
            hi = float(self.lim_hi.get()) if hi is None else hi
        except ValueError:
            self.log_line("limite de tilt no valido", "err")
            return
        if not valid_y_lim(lo, hi):
            self.log_line("limites de tilt no validos: suelo < cielo, entre "
                          "-90 y +90, con al menos 5° de recorrido", "err")
            return
        self.y_lim = (lo, hi)
        self._show_y_lim()
        try:
            save_y_lim(lo, hi)
        except OSError as exc:
            self.log_line(f"no se pudieron guardar los limites ({exc})", "warn")
        self.log_line(f"tilt Y permitido: {lo:+g}° (suelo) a {hi:+g}° (cielo)",
                      "info")
        if self.link.connected:
            ylo, yhi = self._lim_us("Y")
            if not ylo <= self.tgt["Y"] <= yhi:
                self.log_line("Y esta fuera de los nuevos limites: va al limite",
                              "warn")
            self._send_y_lim()
        self._redraw_dials()

    # --------------------------- movimiento ---------------------------------
    def _axis_busy(self, axis):
        if self.jogging[axis]:
            return True
        if self.att[axis] and self.cur[axis] != self.tgt[axis]:
            return True
        return time.time() - self.move_sent[axis] < CMD_SETTLE_S

    def _mark_move(self, axis, tgt_us):
        # estado optimista: el gate nunca depende de un STATUS de hace 200 ms
        self.move_sent[axis] = time.time()
        self.att[axis] = True
        self.tgt[axis] = tgt_us

    def jog_start(self, axis, direction, src):
        self.jog_src[axis].add(src)
        if self.jogging[axis] == direction:
            return
        other = "Y" if axis == "X" else "X"
        if self.seq_var.get() and self._axis_busy(other):
            self.jog_src[axis].discard(src)
            self.log_line("bloqueado: el otro eje aun se mueve "
                          "(modo un-eje-a-la-vez)", "warn")
            return
        self._pending_y = None
        inv = INVERT_X if axis == "X" else INVERT_Y
        d = -direction if inv else direction
        lo, hi = self._lim_us(axis)
        tgt = hi if d > 0 else lo
        self.jogging[axis] = direction
        if self.send(f"{axis} {tgt}"):
            self._mark_move(axis, tgt)
        else:
            self.jogging[axis] = 0
            self.jog_src[axis].discard(src)

    def jog_stop(self, axis, src):
        self.jog_src[axis].discard(src)
        if self.jog_src[axis] or self.jogging[axis] == 0:
            return
        self.jogging[axis] = 0
        self.send("SX" if axis == "X" else "SY")
        self.tgt[axis] = self.cur[axis]

    def stop_all(self):
        self._pending_y = None
        self.jogging = {"X": 0, "Y": 0}
        self.jog_src = {"X": set(), "Y": set()}
        self.send("STOP")
        self.tgt = dict(self.cur)
        for axis in "XY":
            if self.pad_rate[axis] is not None:
                self._restore_rate(axis)

    def set_speed(self, value):
        self.speed_var.set(value)
        self._push_speed()

    def _speed_changed(self, _evt=None):
        self.speed_lbl.configure(text=f"{self.speed_var.get():.1f} °/s")
        if self._speed_job:
            self.root.after_cancel(self._speed_job)
        self._speed_job = self.root.after(350, self._push_speed)

    def _push_speed(self):
        self._speed_job = None
        v = self.speed_var.get()
        self.speed_lbl.configure(text=f"{v:.1f} °/s")
        if self.link.connected:
            self.send(f"RATEX {max(5, int(v * X_US_PER_DEG))}", log=False)
            self.send(f"RATEY {max(5, int(v * Y_US_PER_DEG))}", log=False)
            self.log_line(f"velocidad -> {v:.1f} °/s", "info")
        # si el mando esta moviendo, su proximo ciclo re-escala a la nueva
        self.pad_rate = {"X": None, "Y": None}

    def _goto_pair(self, x_us, y_us):
        self._pending_y = None
        if self.seq_var.get():
            if self._axis_busy("X") or self._axis_busy("Y"):
                self.log_line("espera: hay un movimiento en curso "
                              "(modo un-eje-a-la-vez)", "warn")
                return
            if self.send(f"X {x_us}"):
                self._mark_move("X", x_us)
                # el envio de Y lo dispara _apply_status cuando X termina
                self._pending_y = (y_us, time.time())
        else:
            if self.send(f"X {x_us}"):
                self._mark_move("X", x_us)
            if self.send(f"Y {y_us}"):
                self._mark_move("Y", y_us)

    def goto(self):
        try:
            gx = float(self.goto_x.get())
            gy = float(self.goto_y.get())
        except ValueError:
            self.log_line("valor de grados no valido", "err")
            return
        gx = max(-X_DEG_TOTAL / 2, min(X_DEG_TOTAL / 2, gx))
        lo, hi = self.y_lim
        if not lo <= gy <= hi:
            gy = max(lo, min(hi, gy))
            self.log_line(f"Y acotado a {gy:+g}° (limites de tilt)", "warn")
        self.log_line(f"ir a X={gx:+.1f}° Y={gy:+.1f}°", "info")
        self._goto_pair(deg_to_us(gx, "X"), deg_to_us(gy, "Y"))

    def center(self):
        self.log_line("centrando", "info")
        lo, hi = self._lim_us("Y")
        self._goto_pair((X_MIN + X_MAX) // 2,
                        max(lo, min(hi, (Y_MIN + Y_MAX) // 2)))

    # ------------------------------ mando -----------------------------------
    def _pad_tick(self):
        st = self.pad.poll() if self.pad_var.get() else None
        self._pad_batt_tick = (self._pad_batt_tick + 1) % 40   # cada ~2 s
        if st is None:
            self._pad_batt = None
        elif self._pad_batt is None or self._pad_batt_tick == 0:
            batt = self.pad.battery()
            if batt != self._pad_batt and batt in ("baja", "vacia"):
                self.log_line(f"mando: bateria {batt}", "warn")
            self._pad_batt = batt
        self._pad_show(st)
        if st is not None and self.link.connected:
            self._pad_apply(st)
        else:
            for axis in "XY":
                self._pad_release(axis)
        self.root.after(PAD_POLL_MS, self._pad_tick)

    def _pad_show(self, st):
        if not self.pad.available:
            text = "pygame no instalado: pip install pygame"
        elif not self.pad_var.get():
            text = "desactivado"
        elif st is None:
            text = "sin mando conectado"
        else:
            text = self.pad.name
        if text != self._pad_text:   # al log solo los cambios de estado
            self._pad_text = text
            self.log_line(f"mando: {text}", "info")
        if st is not None:   # palancas en vivo, para ver que el mando responde
            text += (f"\nizq {st['lx']:+.1f} {st['ly']:+.1f} · "
                     f"der {st['rx']:+.1f} {st['ry']:+.1f}")
        if text != self.pad_lbl.cget("text"):
            self.pad_lbl.configure(text=text, fg=C_OK if st else C_MUTED)
        shown = self._pad_batt if st is not None else "-"
        if shown != self._batt_shown:
            self._batt_shown = shown
            if st is None:
                self.batt_box.grid_remove()
            else:
                self._draw_battery(self._pad_batt)
                self.batt_box.grid()

    BATT_BARS = {"vacia": 0, "baja": 1, "media": 2, "llena": 3}

    def _draw_battery(self, level):
        """Pila de 3 rayas (SDL da 4 niveles); rayo = cargando por cable."""
        c = self.batt_cv
        c.delete("all")
        bars = self.BATT_BARS.get(level)
        color = {0: C_ERR, 1: C_WARN}.get(bars, C_OK)
        edge = C_ERR if bars == 0 else C_MUTED
        c.create_rectangle(2, 3, 32, 15, outline=edge, width=2)
        c.create_rectangle(33, 6, 36, 12, fill=edge, outline="")
        if bars is not None:
            for i in range(bars):
                x = 5 + i * 9
                c.create_rectangle(x, 6, x + 7, 12, fill=color, outline="")
        elif level == "con cable":
            c.create_polygon(19, 4, 11, 10, 16, 10, 13, 15, 22, 8, 17, 8,
                             fill=C_WARN, outline="")
        else:
            c.create_text(17, 9, text="?", fill=C_MUTED,
                          font=("Segoe UI", 8, "bold"))

    @staticmethod
    def _pad_curve(v):
        # cuadratica: fina cerca del centro, toda la velocidad al tope
        a = abs(v)
        if a <= PAD_DEADZONE:
            return 0.0
        k = min(1.0, (a - PAD_DEADZONE) / (1 - PAD_DEADZONE))
        return math.copysign(k * k, v)

    def _pad_apply(self, st):
        for b in st["pressed"]:
            if b == pygame.CONTROLLER_BUTTON_B:
                self.log_line("mando: STOP", "warn")
                self.stop_all()
            elif b == "ZL":
                self._pad_preset(-1)
            elif b == "ZR":
                self._pad_preset(+1)

        speed = {}
        for axis, main, fine in (("X", st["lx"], st["rx"]),
                                 ("Y", st["ly"], st["ry"])):
            s_main = self._pad_curve(main)
            s_fine = self._pad_curve(fine) * PAD_FINE
            speed[axis] = s_main if abs(s_main) >= abs(s_fine) else s_fine
        if self.seq_var.get():   # un eje a la vez: manda el mas inclinado
            weak = "Y" if abs(speed["X"]) >= abs(speed["Y"]) else "X"
            speed[weak] = 0.0
        for axis in "XY":
            self._pad_drive(axis, speed[axis])

    def _pad_drive(self, axis, s):
        if s == 0.0:
            self._pad_release(axis)
            return
        direction = 1 if s > 0 else -1
        per_deg = X_US_PER_DEG if axis == "X" else Y_US_PER_DEG
        rate = max(5, int(abs(s) * self.speed_var.get() * per_deg))
        if "pad" in self.jog_src[axis] and self.jogging[axis] == direction:
            last = self.pad_rate[axis]
            if last is None or (abs(rate - last) >= max(3, last // 10) and
                                time.time() - self.pad_rate_ts[axis] >= 0.1):
                self._pad_set_rate(axis, rate)
            return
        if self.jog_src[axis] - {"pad"}:
            return   # el teclado o el mouse ya mueven este eje
        other = "Y" if axis == "X" else "X"
        if self.seq_var.get() and self._axis_busy(other):
            return   # espera callado a que el otro eje termine
        self._pad_set_rate(axis, rate)
        self.jog_start(axis, direction, "pad")

    def _pad_set_rate(self, axis, rate):
        if self.send(f"RATE{axis} {rate}", log=False):
            self.pad_rate[axis] = rate
            self.pad_rate_ts[axis] = time.time()

    def _pad_release(self, axis):
        if "pad" not in self.jog_src[axis]:
            return
        self.jog_stop(axis, "pad")
        self._restore_rate(axis)

    def _restore_rate(self, axis):
        # el mando cambio la velocidad del eje: vuelve a la elegida en la GUI
        per_deg = X_US_PER_DEG if axis == "X" else Y_US_PER_DEG
        self.send(f"RATE{axis} {max(5, int(self.speed_var.get() * per_deg))}",
                  log=False)
        self.pad_rate[axis] = None

    def _pad_preset(self, step):
        vals = [v for _, v in SPEED_PRESETS]
        cur = self.speed_var.get()
        idx = min(range(len(vals)), key=lambda i: abs(vals[i] - cur))
        idx = max(0, min(len(vals) - 1, idx + step))
        self.set_speed(vals[idx])
        self.log_line(f"mando: velocidad {SPEED_PRESETS[idx][0]} "
                      f"{vals[idx]:g} °/s", "info")

    # ---------------------------- teclado -----------------------------------
    KEYMAP = {"Left": ("X", -1), "Right": ("X", +1),
              "Up": ("Y", +1), "Down": ("Y", -1)}

    def _key_press(self, event):
        if isinstance(event.widget, (tk.Spinbox, tk.Entry, ttk.Combobox)):
            return
        if event.keysym in self.KEYMAP and event.keysym not in self.keys_down:
            self.keys_down.add(event.keysym)
            axis, d = self.KEYMAP[event.keysym]
            self.jog_start(axis, d, "key")
        elif event.keysym == "space":
            self.stop_all()

    def _key_release(self, event):
        if event.keysym in self.KEYMAP:
            self.keys_down.discard(event.keysym)
            axis, _ = self.KEYMAP[event.keysym]
            self.jog_stop(axis, "key")

    def _app_focus_check(self):
        # Si la app entera perdio el foco con una tecla mantenida, Windows
        # entrega el KeyRelease a otra ventana: detener el jog huerfano.
        try:
            if self.root.focus_get() is not None:
                return
        except (KeyError, tk.TclError):
            return
        self.keys_down.clear()
        # el mando sigue mandando en segundo plano: solo teclado/mouse quedan
        # huerfanos al perder el foco
        if any(self.jog_src[a] & {"key", "mouse"} for a in "XY"):
            self.log_line("foco perdido con jog activo -> STOP", "warn")
            self.stop_all()

    # ------------------------- refresco periodico ---------------------------
    def _tick(self):
        try:
            while True:
                kind, line = self.rxq.get_nowait()
                if kind == "lost":
                    self.disconnect("conexion perdida")
                    continue
                if kind == "found":
                    self._show_found(line)
                    continue
                if line.startswith(("OK", "ERR", "PONG")):
                    self.awaiting_reply = False
                m = STATUS_RE.match(line)
                if m:
                    self._apply_status(m)
                    if self.dbg_var.get():
                        self.log_line(line, "dim")
                elif line.startswith("PONG"):
                    self.pong_ok = True
                    self.log_line(f"< {line}", "rx")
                    if self._pong_late:   # p. ej. el UNO aun esperaba DHCP
                        self._pong_late = False
                        self._check_pong()
                elif line.startswith("ERR"):
                    self.log_line(f"< {line}", "err")
                elif line.startswith("AUTO DETACH"):
                    self.log_line(f"< {line} (reposo, sin zumbido)", "warn")
                elif line.startswith("WATCHDOG"):
                    self.log_line(f"< {line} (enlace callado con movimiento)",
                                  "warn")
                elif line.startswith("UFOMOUNT"):
                    self.log_line(f"< {line}", "info")
                else:
                    self.log_line(f"< {line}", "rx")
        except queue.Empty:
            pass

        if self.link.connected and time.time() - self.last_tx > STATUS_POLL_S:
            try:
                self.link.write_line("STATUS")
                self.last_tx = time.time()
            except Exception as exc:
                self.disconnect(f"ERROR de escritura ({exc}); desconectado")

        self.root.after(50, self._tick)

    def _apply_status(self, m):
        self.att["X"], self.att["Y"] = m.group(1) == "1", m.group(2) == "1"
        self.cur["X"], tgt_x = int(m.group(3)), int(m.group(4))
        self.cur["Y"], tgt_y = int(m.group(7)), int(m.group(8))
        # el tgt reportado solo pisa el local pasada la ventana de asentamiento
        if time.time() - self.move_sent["X"] >= CMD_SETTLE_S:
            self.tgt["X"] = tgt_x
        if time.time() - self.move_sent["Y"] >= CMD_SETTLE_S:
            self.tgt["Y"] = tgt_y

        # si otro cliente (USB) cambio los limites de Y, la GUI los repone
        fw_lim = (int(m.group(9)), int(m.group(10)))
        if (self.pong_ok and fw_lim != self._lim_us("Y")
                and time.time() - self.lim_sent >= 3):
            self.log_line(f"el firmware tenia Y limitado a {fw_lim[0]}-"
                          f"{fw_lim[1]} us; se reponen los de la GUI", "warn")
            self._send_y_lim()

        # goto secuencial dirigido por estado: Y sale cuando X termino
        if self._pending_y is not None:
            y_us, t0 = self._pending_y
            if (time.time() - t0 >= CMD_SETTLE_S and self.jogging["X"] == 0
                    and self.cur["X"] == self.tgt["X"]):
                self._pending_y = None
                if self.send(f"Y {y_us}"):
                    self._mark_move("Y", y_us)

        dx = us_to_deg(self.cur["X"], "X")
        dy = us_to_deg(self.cur["Y"], "Y")
        self.deg_x.configure(text=f"{dx:+.1f}°")
        self.deg_y.configure(text=f"{dy:+.1f}°")
        # desacoplado el firmware no avanza la rampa: cur != tgt no es movimiento
        sx = "reposo" if not self.att["X"] else \
             ("moviendo" if self.cur["X"] != self.tgt["X"] else "sosteniendo")
        sy = "reposo" if not self.att["Y"] else \
             ("moviendo" if self.cur["Y"] != self.tgt["Y"] else "sosteniendo")
        self.us_x.configure(text=f"{self.cur['X']} us · {sx}")
        self.us_y.configure(text=f"{self.cur['Y']} us · {sy}")
        self._redraw_dials()

    # ------------------- diales: donde mira la camara -----------------------
    FOV_HALF = 22          # semiancho del cono de vision dibujado (grados)

    def _redraw_dials(self):
        self._draw_pan_dial()
        self._draw_tilt_dial()

    def _draw_pan_dial(self):
        """Vista superior: arco de 270 con la zona ciega trasera rayada.
        0 grados = frente (arriba); + = giro a la derecha en pantalla."""
        c = self.dial_x
        w, h = c.winfo_width(), c.winfo_height()
        if w < 60 or h < 60:
            return
        c.delete("all")
        cx, cy = w / 2, h / 2
        rad = min(w, h) / 2 - 16
        box = (cx - rad, cy - rad, cx + rad, cy + rad)

        # disco alcanzable (270) + sector ciego trasero (90, rayado)
        c.create_arc(*box, start=-45, extent=270, style="pieslice",
                     fill=C_PANEL2, outline=C_LINE)
        c.create_arc(*box, start=225, extent=90, style="pieslice",
                     fill=C_BG, outline=C_LINE, stipple="gray25")

        pan = us_to_deg(self.cur["X"], "X")
        tgt = us_to_deg(self.tgt["X"], "X")

        # cono de vision de la camara
        c.create_arc(*box, start=90 - pan - self.FOV_HALF,
                     extent=2 * self.FOV_HALF, style="pieslice",
                     fill="#4A2E14", outline="")

        # ticks y etiquetas
        for deg in range(-135, 136, 45):
            a = math.radians(90 - deg)
            c.create_line(cx + (rad - 6) * math.cos(a),
                          cy - (rad - 6) * math.sin(a),
                          cx + rad * math.cos(a),
                          cy - rad * math.sin(a), fill=C_MUTED)
        for deg, txt in ((-135, "-135°"), (0, "0°"), (135, "+135°")):
            a = math.radians(90 - deg)
            c.create_text(cx + (rad + 11) * math.cos(a),
                          cy - (rad + 11) * math.sin(a),
                          text=txt, fill=C_MUTED, font=("Segoe UI", 7))

        # objetivo (punteado) y aguja de la camara
        if self.tgt["X"] != self.cur["X"]:
            a = math.radians(90 - tgt)
            c.create_line(cx, cy, cx + (rad - 4) * math.cos(a),
                          cy - (rad - 4) * math.sin(a),
                          fill=C_MUTED, dash=(3, 3))
        a = math.radians(90 - pan)
        c.create_line(cx, cy, cx + (rad - 4) * math.cos(a),
                      cy - (rad - 4) * math.sin(a),
                      fill=C_X, width=3, arrow=tk.LAST)
        c.create_oval(cx - 5, cy - 5, cx + 5, cy + 5, fill=C_TEXT, outline="")

    def _draw_tilt_dial(self):
        """Vista lateral: semicirculo de 180. 0 = horizonte (derecha),
        +90 = cenit (arriba), -90 = nadir (abajo)."""
        c = self.dial_y
        w, h = c.winfo_width(), c.winfo_height()
        if w < 60 or h < 60:
            return
        c.delete("all")
        rad = min(h / 2 - 14, w - 74)
        cx, cy = max(10, (w - rad) / 2 - 14), h / 2
        box = (cx - rad, cy - rad, cx + rad, cy + rad)

        # recorrido disponible (verde) y bloqueado (rojo): relleno + borde
        lo, hi = self.y_lim
        zones = ((-90, lo + 90, C_ZONE_BAD, C_LIM_BAD),
                 (lo, hi - lo, C_ZONE_OK, C_LIM_OK),
                 (hi, 90 - hi, C_ZONE_BAD, C_LIM_BAD))
        ring = (cx - rad + 4, cy - rad + 4, cx + rad - 4, cy + rad - 4)
        for start, extent, fill, edge in zones:
            if extent <= 0:
                continue
            c.create_arc(*box, start=start, extent=extent, style="pieslice",
                         fill=fill, outline="")
            c.create_arc(*ring, start=start, extent=extent, style="arc",
                         outline=edge, width=8)
        c.create_arc(*box, start=-90, extent=180, style="pieslice",
                     fill="", outline=C_LINE)

        tilt = us_to_deg(self.cur["Y"], "Y")
        tgt = us_to_deg(self.tgt["Y"], "Y")

        # cono de vision
        c.create_arc(*box, start=tilt - self.FOV_HALF,
                     extent=2 * self.FOV_HALF, style="pieslice",
                     fill="#173246", outline="")

        # horizonte
        c.create_line(cx, cy, cx + rad, cy, fill=C_LINE, dash=(3, 3))

        # ticks y etiquetas
        for deg in range(-90, 91, 45):
            a = math.radians(deg)
            c.create_line(cx + (rad - 6) * math.cos(a),
                          cy - (rad - 6) * math.sin(a),
                          cx + rad * math.cos(a),
                          cy - rad * math.sin(a), fill=C_MUTED)
        for deg, txt in ((90, "+90° cielo"), (0, "0° horizonte"),
                         (-90, "-90° suelo")):
            a = math.radians(deg)
            c.create_text(cx + (rad + 8) * math.cos(a) + (18 if deg == 0 else 0),
                          cy - (rad + 10) * math.sin(a),
                          text=txt, fill=C_MUTED, font=("Segoe UI", 7),
                          anchor="w" if deg == 0 else "center")
        for deg in (lo, hi):
            a = math.radians(deg)
            c.create_line(cx, cy, cx + rad * math.cos(a), cy - rad * math.sin(a),
                          fill=C_LIM_OK, dash=(2, 3))
            c.create_text(cx + (rad + 6) * math.cos(a),
                          cy - (rad + 6) * math.sin(a),
                          text=f"{deg:+g}°", fill=C_LIM_OK,
                          font=("Segoe UI", 8, "bold"), anchor="w")

        # objetivo (punteado) y aguja de la camara
        if self.tgt["Y"] != self.cur["Y"]:
            a = math.radians(tgt)
            c.create_line(cx, cy, cx + (rad - 4) * math.cos(a),
                          cy - (rad - 4) * math.sin(a),
                          fill=C_MUTED, dash=(3, 3))
        a = math.radians(tilt)
        c.create_line(cx, cy, cx + (rad - 4) * math.cos(a),
                      cy - (rad - 4) * math.sin(a),
                      fill=C_Y, width=3, arrow=tk.LAST)
        c.create_oval(cx - 5, cy - 5, cx + 5, cy + 5, fill=C_TEXT, outline="")

    def _on_close(self):
        self._pending_y = None
        if self.link.connected:
            try:
                self.link.write_line("STOP")
            except Exception:
                pass
        self.link.close()
        self.root.destroy()


def _read_text(ser):
    # read(n) con timeout devuelve lo llegado en esa ventana (USB y TCP;
    # read_all() no sirve por TCP: in_waiting del socket vale 0 o 1)
    return ser.read(4096).decode("ascii", errors="replace").strip()


def check_mode(port):
    net = is_net_port(port)
    print(f"Abriendo {port}" + (" por red..." if net else
                                " (el UNO se resetea)..."))
    ser = open_port(port, timeout=0.5)
    if not net:
        time.sleep(BOOT_WAIT_S)
    banner = _read_text(ser)
    if banner or not net:   # por TCP pyserial puede descartar el saludo al abrir
        print(f"BOOT: {banner}")
    for cmd in ("PING", "STATUS", "NET"):
        ser.write(cmd.encode("ascii") + b"\n")
        print(f"{cmd}: {_read_text(ser)}")
    ser.close()
    print("OK")


def main():
    ap = argparse.ArgumentParser(description="Control PTZ ufomount")
    ap.add_argument("--check", action="store_true",
                    help="prueba de conexion sin GUI")
    ap.add_argument("--find", nargs="?", const="", metavar="IP",
                    help="busca monturas en la red local (y en la red /24 de "
                         "IP, si se da) y sale")
    ap.add_argument("--port", default=None,
                    help="COMx (USB) o IP[:puerto] (red, puerto 5000 por "
                         "defecto); sin indicar: el ultimo que conecto o la "
                         "red")
    args = ap.parse_args()
    if args.find is not None:
        found = discover(set(ip_hints(args.find)))
        for ip, text in sorted(found.items()):
            print(f"{ip}  {text}")
        if not found:
            print("ninguna montura encontrada")
        return
    if args.check:
        check_mode(args.port or PORT_DEFAULT)
        return
    root = tk.Tk()
    PtzGui(root, port=args.port or load_cfg().get("port") or NET_DEFAULT)
    root.mainloop()


if __name__ == "__main__":
    main()
