GGm4nS3c/ufomount/(commit log)

2026-09-03 Montura PTZ ufomount: firmware v3, GUI de control y documentacion
    Firmware Arduino UNO (protocolo serie, rampas, auto-detach, watchdog),
    interfaz tkinter con diales de posicion y logs, scripts de verificacion
    y medicion, e informe tecnico de los servos GX3350ProBLS.
2026-10-26 Control por red (shield Ethernet), servos en D2/D3 y limites de tilt
    - Firmware v4: servidor TCP en 192.168.200.50:5000 con el mismo protocolo
    de lineas que el USB, comando NET, watchdog por canal y STOP si se cae
    la conexion que movia la montura.
    - Servos movidos a X->D2 e Y->D3: la shield usa D10-D13 y D4, y D8/D9
    daban mal contacto junto a D10.
    - Tilt Y limitado por defecto de -50 (suelo) a +30 (cielo) para que la
    camara no tope (LIMY 944 1833 al arrancar).
    - GUI: conexion por IP, limites de tilt configurables y guardados en
    ~/.ufomount_ptz.json, enviados al conectar; dial con zona permitida en
    verde y bloqueada en rojo.
    - firmware/ledweb: pagina web de prueba de la shield (LE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
2026-10-26 GUI: control por mando (tambien en segundo plano) y eje X invertido
    - Mando via pygame/SDL (probado con Switch Pro por USB; sirven Xbox,
    PlayStation y genericos): se lee aunque la ventana no tenga el foco.
    - Palanca izquierda mueve pan/tilt con velocidad proporcional hasta la
    elegida en la GUI; la derecha hace lo mismo al 25 % (ajuste fino).
    B = STOP, ZL/ZR (L2/R2) = preset de velocidad anterior/siguiente.
    - Respeta los limites del tilt; al soltar la palanca el eje se detiene
    y vuelve la velocidad de la GUI.
    - Muestra el mando, su bateria (4 niveles de SDL) y las palancas en vivo.
    - "Mover ejes de a uno" desmarcado por defecto.
    - INVERT_X: el servo X gira al reves; mando, teclado y d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
2026-10-26 GUI: icono de bateria del mando y puerto recordado
    - La bateria del mando se muestra como icono en la barra superior
    (3 rayas segun los 4 niveles de SDL; rayo = cargando por cable).
    - La GUI recuerda el ultimo puerto que conecto (~/.ufomount_ptz.json)
    y, sin puerto guardado, abre en la red (192.168.200.50:5000) en vez
    de COM5: el .exe sirve con doble clic en otro equipo.
    - README: puerto por defecto y notas del .exe (mando incluido,
    SmartScreen).
2026-10-26 README: captura de la GUI conectada a la montura
2026-10-27 Firmware v4.1: IP por DHCP y busqueda de la montura desde la GUI
    - Firmware: al encender pide IP por DHCP (8 s); sin servidor usa la IP
    fija de respaldo 192.168.200.50. Renueva el prestamo (maintain) y NET
    indica si la IP es dhcp o fija.
    - Descubrimiento por UDP 5000: a "UFOMOUNT?" contesta con su IP.
    - GUI: boton Buscar (y --find): broadcast en la red local y, para la red
    /24 de la IP escrita en Puerto, un paquete a cada direccion (el
    broadcast no cruza routers).
    - GUI: si el PONG llega tarde (el UNO aun esperando DHCP por USB), la
    conexion se da por buena al llegar.
    - README: red por DHCP, Buscar y reserva de IP en el router.
    Sin probar con la montura: el firmware se compila per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
